lvd2/zxnetusb/reports/2019_dihalt_summer/epm3128_pre.jpg

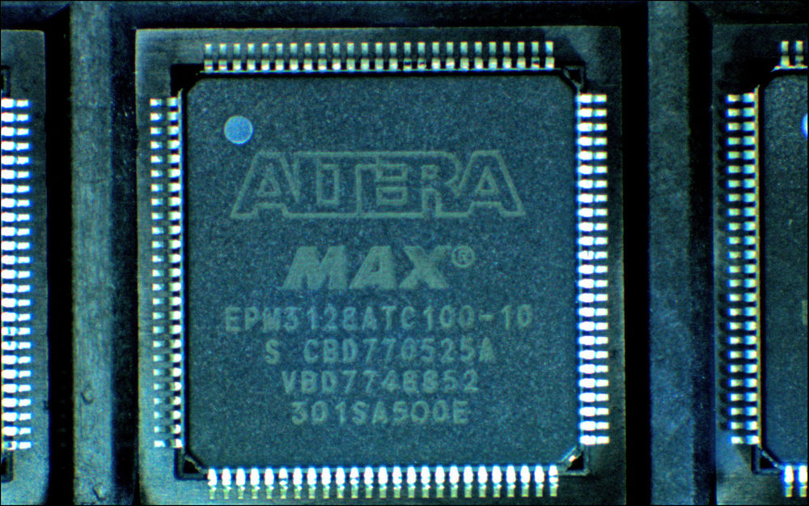
reports/2019_dihalt_summer/epm3128_pre.jpg
