lvd2/zxnetusb/reports/2019_dihalt_summer/W5300.jpg

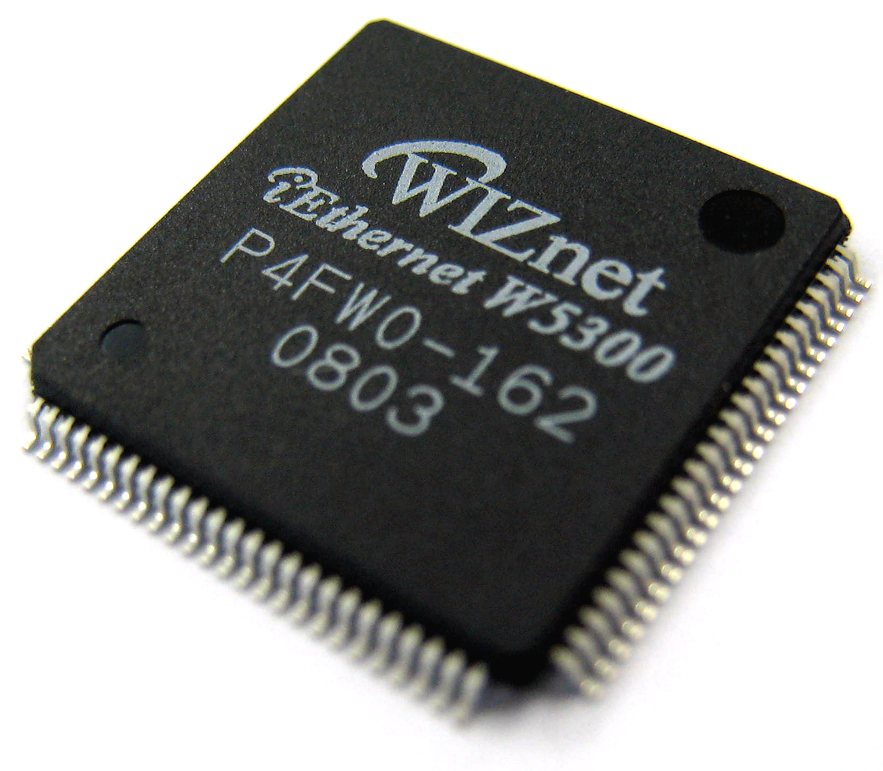
reports/2019_dihalt_summer/W5300.jpg
