lvd2/zxnetusb/pcad/readme.txt

Revision A: initial

Revision B:
- Исправлено RJ45 element.
- ПОдвинут USB разъем ровно по краю платы.
