lvd2/zxnetusb/pcad/revC4/photos/DSCN5782.png

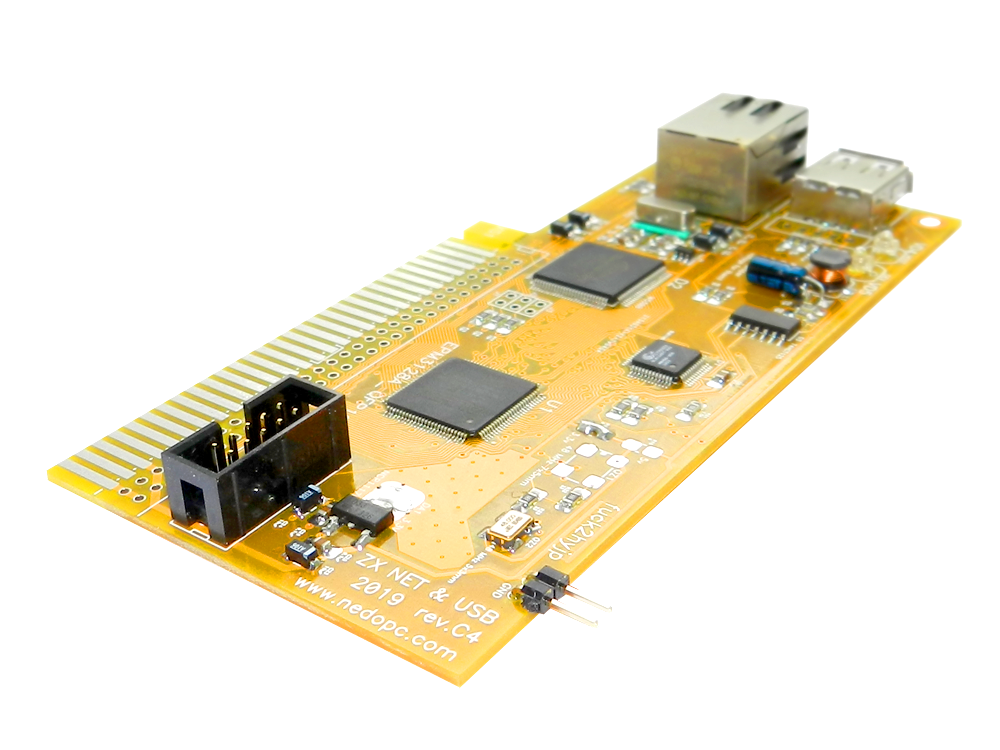
pcad/revC4/photos/DSCN5782.png
