lvd2/zxnetusb/pcad/revC4/photos/revC4_bot.jpg

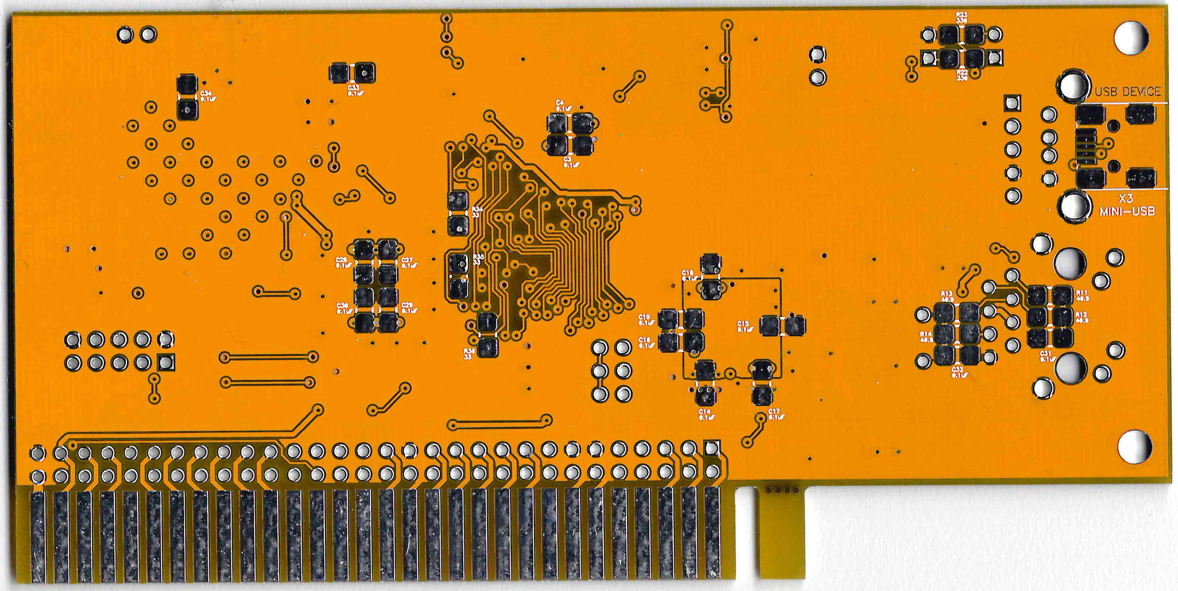
pcad/revC4/photos/revC4_bot.jpg
