lvd2/zxnetusb/pcad/revC4/photos/revC4_top.jpg

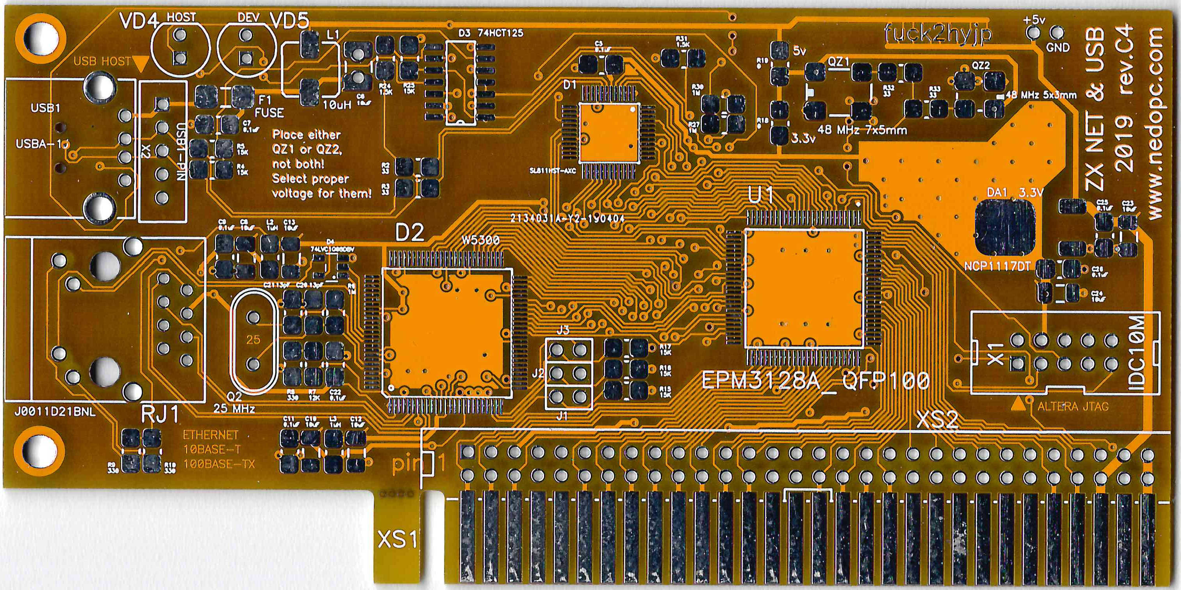
pcad/revC4/photos/revC4_top.jpg
