lvd2/zxnetusb/reports/2019_cafe/abstract/333.png

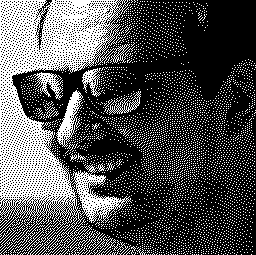
reports/2019_cafe/abstract/333.png
