lvd2/zxnetusb/reports/2019_cafe/w5100_1.jpg

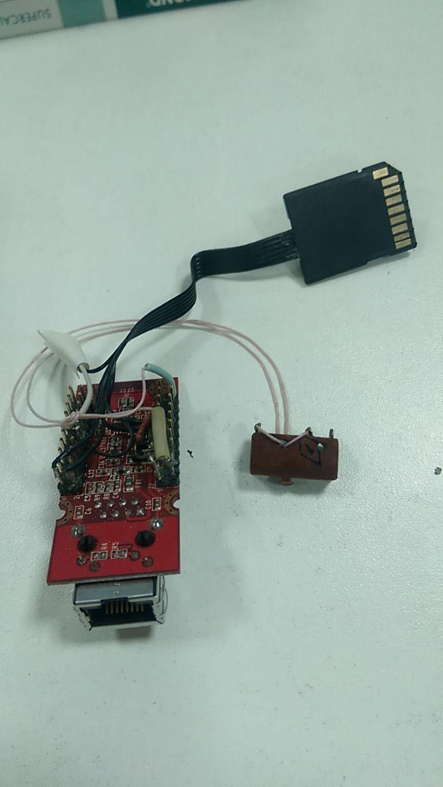
reports/2019_cafe/w5100_1.jpg
