lvd2/zxnetusb/reports/2019_cafe/w5100_2.jpg

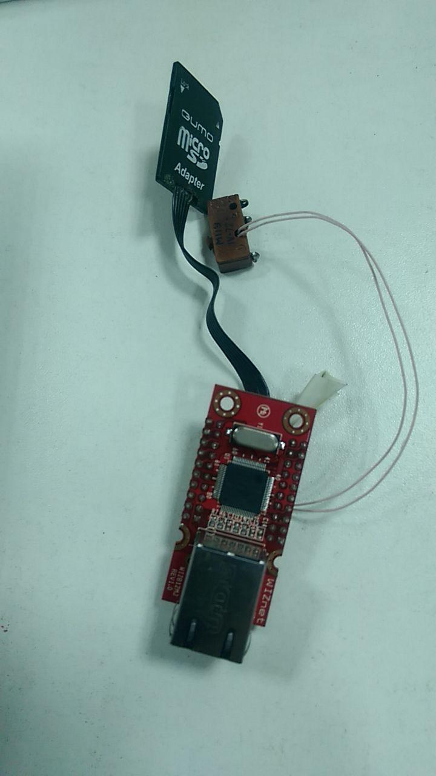
reports/2019_cafe/w5100_2.jpg
