lvd2/zxnetusb/pcad/revC4/zxinet_bom.ods

Количество/Count | Обозначение/RefDes | Тип/Type | Корпус/Package | Номинал/Value | Комменатрии/Comments
1 | U1 | Altera EPM3128ATC100-10N | QFP 100
1 | D1 | Cypress SL811HS | QFP 48
1 | D2 | Wiznet W5300 | QFP 100
1 | D3 | 74HCT125 | SOIC 14
1 | D4 | 74LVC1G08DBV | SOT23-5 |  | также/also 74HC1G08
1 | DA1 | NCP1117DT | DPAK, SOT223 | 3.3V | также/also LM1117-3.3
23 | C3 | Ceramic capacitor | 0805, 1206 | 0.1uF X7R
 | C4 | Ceramic capacitor | 0805, 1206 | 0.1uF X7R
 | C5 | Ceramic capacitor | 0805, 1206 | 0.1uF X7R
 | C7 | Ceramic capacitor | 0805, 1206 | 0.1uF X7R
 | C9 | Ceramic capacitor | 0805, 1206 | 0.1uF X7R
 | C11 | Ceramic capacitor | 0805, 1206 | 0.1uF X7R
 | C14 | Ceramic capacitor | 0805, 1206 | 0.1uF X7R
 | C15 | Ceramic capacitor | 0805, 1206 | 0.1uF X7R
 | C16 | Ceramic capacitor | 0805, 1206 | 0.1uF X7R
 | C17 | Ceramic capacitor | 0805, 1206 | 0.1uF X7R
 | C18 | Ceramic capacitor | 0805, 1206 | 0.1uF X7R
 | C19 | Ceramic capacitor | 0805, 1206 | 0.1uF X7R
 | C22 | Ceramic capacitor | 0805, 1206 | 0.1uF X7R
 | C25 | Ceramic capacitor | 0805, 1206 | 0.1uF X7R
 | C26 | Ceramic capacitor | 0805, 1206 | 0.1uF X7R
 | C27 | Ceramic capacitor | 0805, 1206 | 0.1uF X7R
 | C28 | Ceramic capacitor | 0805, 1206 | 0.1uF X7R
 | C29 | Ceramic capacitor | 0805, 1206 | 0.1uF X7R
 | C30 | Ceramic capacitor | 0805, 1206 | 0.1uF X7R
 | C31 | Ceramic capacitor | 0805, 1206 | 0.1uF X7R
 | C32 | Ceramic capacitor | 0805, 1206 | 0.1uF X7R
 | C33 | Ceramic capacitor | 0805, 1206 | 0.1uF X7R | Устанавливать только один из двух/Install only one of two
 | C34 | Ceramic capacitor | 0805, 1206 | 0.1uF X7R | Устанавливать только один из двух/Install only one of two
2 | C20 | Ceramic capacitor | 0805, 1206 | 13pF NPO
 | C21 | Ceramic capacitor | 0805, 1206 | 13pF NPO
6 | C8 | Tantalum capacitor | 1206 (A) | 10uF 16v
 | C10 | Tantalum capacitor | 1206 (A) | 10uF 16v
 | C12 | Tantalum capacitor | 1206 (A) | 10uF 16v
 | C13 | Tantalum capacitor | 1206 (A) | 10uF 16v
 | C23 | Tantalum capacitor | 1206 (A) | 10uF 16v
 | C24 | Tantalum capacitor | 1206 (A) | 10uF 16v
1 | C6 | Tantalum capacitor | 1206 (A) | 10uF 16v
1 | L1 | Inductor | CDR64B | 10uH | CDRH64B, 1812 (4.5mm*2.5mm), любой/any other на ток/current >0.5A размер не более/size not greater than 6x6mm
2 | L2 | Chip inductor | 0805, 1206 | 1uH
 | L3 | Chip inductor | 0805, 1206 | 1uH
1 | F1 | FUSE | SMD1210
2 | R18 | Resistor | 0805, 1206 | 0 Ohm or solder bridge | Устанавливать только один из двух/Install only one of two
 | R19 | Resistor | 0805, 1206 | 0 Ohm or solder bridge | Устанавливать только один из двух/Install only one of two
3 | R6 | Resistor | 0805, 1206 | 1M
 | R27 | Resistor | 0805, 1206 | 1M
 | R30 | Resistor | 0805, 1206 | 1M
2 | R24 | Resistor | 0805, 1206 | 1.5K
 | R31 | Resistor | 0805, 1206 | 1.5K
1 | R7 | Resistor | 0805, 1206 | 12K
6 | R4 | Resistor | 0805, 1206 | 15K
 | R5 | Resistor | 0805, 1206 | 15K
 | R15 | Resistor | 0805, 1206 | 15K
 | R16 | Resistor | 0805, 1206 | 15K
 | R17 | Resistor | 0805, 1206 | 15K
 | R25 | Resistor | 0805, 1206 | 15K
7 | R2 | Resistor | 0805, 1206 | 33
 | R3 | Resistor | 0805, 1206 | 33
 | R32 | Resistor | 0805, 1206 | 33 | Устанавливать только один из двух/Install only one of two
 | R33 | Resistor | 0805, 1206 | 33 | Устанавливать только один из двух/Install only one of two
 | R34 | Resistor | 0805, 1206 | 33
 | R35 | Resistor | 0805, 1206 | 33
 | R36 | Resistor | 0805, 1206 | 33
4 | R11 | Resistor | 0805, 1206 | 49.9
 | R12 | Resistor | 0805, 1206 | 49.9
 | R13 | Resistor | 0805, 1206 | 49.9
 | R14 | Resistor | 0805, 1206 | 49.9
5 | R8 | Resistor | 0805, 1206 | 330
 | R9 | Resistor | 0805, 1206 | 330
 | R10 | Resistor | 0805, 1206 | 330
 | R22 | Resistor | 0805, 1206 | 330
 | R23 | Resistor | 0805, 1206 | 330
1 | Q2 | Quartz crystal | HC-49 | 25.0 MHz
1 | QZ2 | Quartz generator | 5mm x 3.2mm | 48.0 MHz | Устанавливать только один из двух/Install only one of two
1 | QZ1 | Quartz generator | 7mm x 5mm | 48.0 MHz | Устанавливать только один из двух/Install only one of two
1 | VD5 | LED | 100mil
1 | VD4 | LED | 100mil
1 | X1 | male connector | IDC10M |  | Altera JTAG
1 | RJ1 | J0011D21B |  |  | также/also J0011D21BNL
1 | J1 | jumper | 2pin 100mil
1 | J2 | jumper | 2pin 100mil
1 | J3 | jumper | 2pin 100mil
1 | X2 | pins | PLS-5
1 | X3 | MINI-USB type B receptacle |  |  | поверхностный монтаж/surface-mount
1 | USB1 | USB type A receptacle |  |  | монтаж в отверстия/through-hole
