lvd2/zxnetusb/doc/revC/zxinet_sch.pdf

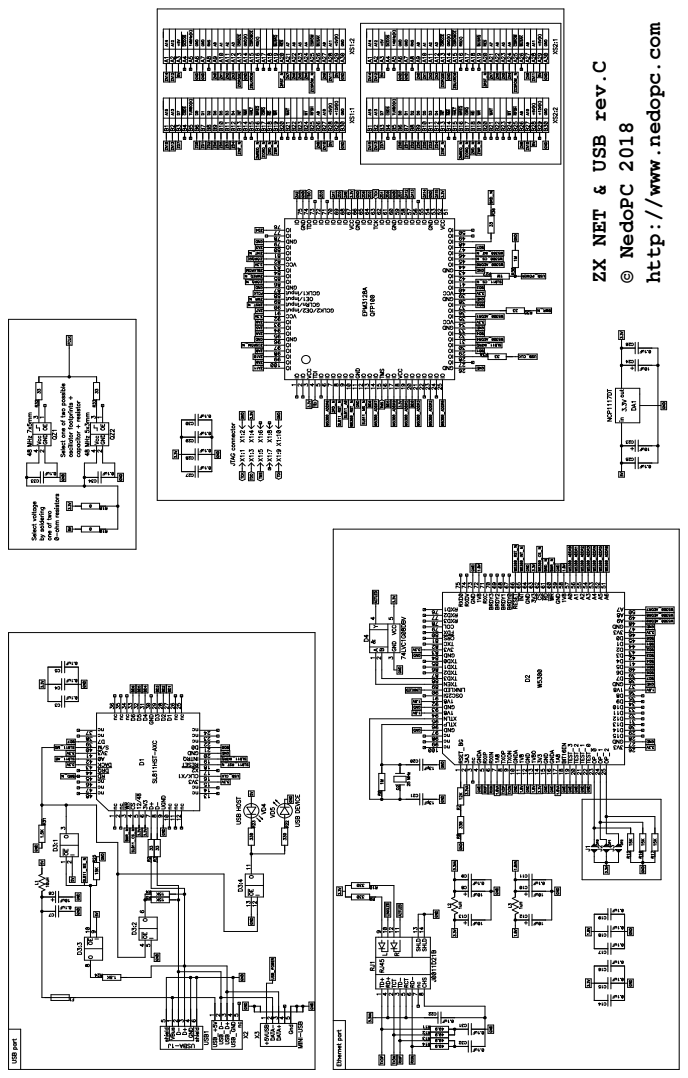
[picture p26: page 1]
© NedoPC 2018

http://www.nedopc.com

ZX NET & USB rev.C
