lvd2/zxnetusb/doc/revA/patch_rev_a.pdf

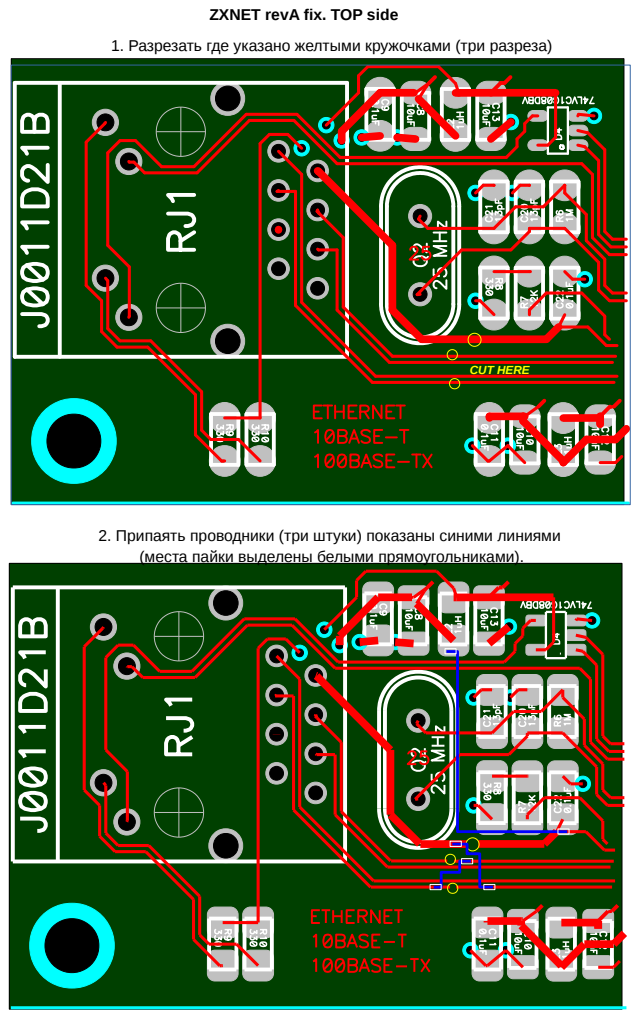
[picture p27: page 1]
CUT HERE

ZXNET revA fix. TOP side

1. Разрезать где указано желтыми кружочками (три разреза)

2. Припаять проводники (три штуки) показаны синими линиями
(места пайки выделены белыми прямоугольниками).

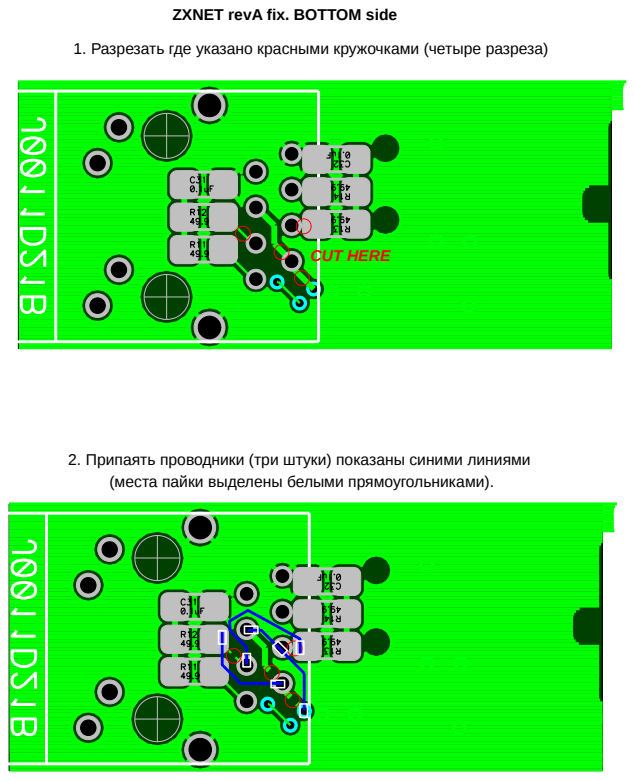
[picture p28: page 2]
CUT HERE

ZXNET revA fix. BOTTOM side

1. Разрезать где указано красными кружочками (четыре разреза)

2. Припаять проводники (три штуки) показаны синими линиями
(места пайки выделены белыми прямоугольниками).
