lvd2/zxnetusb/(list of files, drawings)

Other design files:
pcad/old/NeoGS.pcb
pcad/revA/zxinet.pcb
pcad/revB/zxinet.pcb
pcad/revC3/zxinet_C3.pcb
pcad/revC4/zxinet.pcb
