lvd2/zxnetusb/(commit log)

2012-10-03 added some old libs and PCBs from other projects
    [NeoGS.pcb]
2012-10-04 added lib from zxcyclone, added ether connector pdf
2012-10-15 add driver w5300
2012-10-24 add USBA-2J connector
2012-10-27 add scheme (SL811 and clockgen)
    [zxinet.sch]
2012-10-27 sch: ethernet & USB frontend part lib: add components
    [zxinet.sch]
2012-10-28 sch: add some elements (close circuit of ethernet transformer)
    [zxinet.sch]
2012-10-31 updated schematics a bit
    [zxinet.sch]
2012-10-31 changed specs: added BRDY read, added USB power control bits
2012-10-31 sch: USB frontend on LM3525M-L lib: add LM3525M-L component
    [zxinet.sch]
2012-11-03 added USB master/slave switching circuits, changed HDL to buffer databus, removed BRDY read from specs
    [zxinet.sch]
2012-11-04 finished USB-part, ZXBUS-part
    [zxinet.sch]
2012-11-06 added usb host and device LEDs, removed some transistors for 74hct125
    [zxinet.sch]
2012-11-11 finished testbench for current cpld code
2012-11-13 lib: add USB pin connector sch: - add USB pin connector - correct USB led part - fill title
    [zxinet.sch]
2012-11-15 lib: add ZXBUS-PIN sch: add ZXBUS-PIN pcb: start version
    [zxinet.pcb, zxinet.sch]
2012-11-15 added transistor repeater for ACTLED light diode
    [zxinet.sch]
2012-11-16 lib: add 74LVC1G08DBV sch: ACTLED on 74LVC1G08DBV
    [zxinet.sch]
2012-11-17 changed pins on CPLD for zxbus
    [zxinet.sch]
2012-11-18 PCB: zxbus and w5300 frontend
    [zxinet.pcb]
2012-11-23 lib: add CD64R ferrit sch: USB ferrit exchange to CD64R pcb: routed board
    [zxinet.pcb, zxinet.sch]
2012-11-24 PCB: diff pairs reroute
    [zxinet.pcb]
2012-11-24 PCB: - C31R11R12 and C32R13R14 to bottom side; - add some text on board.
    [zxinet.pcb]
2012-12-02 LIB: Add MIC2025-YM SCH: Alternative usb power switch on MIC2025-YM PCB: Add alternative power switch on bottom side
    [zxinet.pcb, zxinet.sch]
2013-03-29 replacement driver for 8 bit version
    [main.c]
2013-04-03 zxiznet: fixed reset behavior of ms bit: now it's reset only on zx reset, not on sl811 reset. doc fixed, new .pof built
    [ports.v]
2013-04-04 Update documents
    [detaly.ods]
2013-04-15 Revision B started
    [zxinet.pcb, zxinet.sch]
2013-09-22 zxiznet: partially removed glitch problem by adding filters to cpld design, more glitches to kill
    [top.v, zbus.v]
2013-10-03 zxiznet: trying to fix glitches...
    [ports.v, ssz80.v, tb.v, top.v, wizmap.v]
2013-10-03 zxiznet: trunk now is without bugfixes, all bugfixes is in branch/ dir
    [top.v, zbus.v]
2013-10-21 add w5300 sample
2017-09-19 trunk: fixed obvious bug in tests
    [tb.v]
2017-09-19 trunk: added clocked filter, patched testbench to pass tests with that filter
2018-01-08 zxiznet: included revC sch and pcb into trunk
    [zxinet.pcb, zxinet.sch, zxinet_tmp.sch]
2018-01-08 zxiznet: making gerbers for revC
    [ZXINET.DRL, ZXINET.GBL, ZXINET.GBO, ZXINET.GBS, ZXINET.GKO, ZXINET.GTL, ZXINET.GTO, ZXINET.GTS]
2018-01-08 zxiznet: finished revC pcb and gerbers
    [zxinet.pcb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]
2018-01-29 zxiznet: added .bom, tidied up files (removed unnecessary ones)
    [zxinet_tmp.sch]
2018-02-04 zxiznet: spawned simpe pin-test for epm3128 (DO NOT INSERT INTO ZXBUS\!\!\!)
2018-02-04 zxiznet: revC: made pin test (see readme and top.v), compiled top.pof of main project, added empty epm config (read from empty device)
2018-02-04 zxiznet: pcad lib: miniUSB corrected (wider gnd pins)
2018-02-05 zxiznet: gerbers archive added
2018-02-05 zxiznet: fixed years in rtl, spawned revC documentation
    [ports.v, top.v, wizmap.v, zbus.v]
2018-02-06 zxiznet: revC schematics: cosmetic changes
    [zxinet.sch]
2018-02-09 zxiznet: fixing for 14mhz: w5300 works OK, sl811 always fails (any freq)
    [zbus.v]
2018-02-11 zxiznet: fixing for 14mhz: sl811 seems to work also, but fix overall is BAAAD. Will do lOOOng tests though
    [tb.v, zbus.v]
2018-02-19 added datasheets to esp32
2018-02-25 zxiznet: added esp32 devkitc schematics
2018-03-04 zxiznet: fix for bad memmapped w5300 reads when extra bytes appeared or some disappearing. still read glitches at 14mhz, when some zero bits of read byte turn to 1 (also memmaped w5300)
    [zbus.v]
2018-03-05 zxiznet: proposed fix for data setup violation in memmaped wiznet memtest
    [zbus.v]
2018-03-05 zxiznet: updated fix for <look prev commit>
    [zbus.v]
2018-03-28 zxiznet: added .svg with schematics
2018-03-29 zxiznet: svg schematics updated
2018-03-29 zxiznet: rev.C: finished PDF schematics, BOM in progress
    [zxinet_bom.ods]
2018-03-29 zxiznet: rev.C: BOM
    [zxinet_bom.ods]
2019-04-03 zxiznet: rev.D added (changes in README)
    [zxinet.pcb, zxinet.sch, zxinet_bom.ods]
2019-04-03 zxiznet: rev.D: added gerbers
    [ZXINET.DRL, ZXINET.GBL, ZXINET.GBO, ZXINET.GBS, ZXINET.GKO, ZXINET.GTL, ZXINET.GTO, ZXINET.GTS]
2019-04-04 zxiznet: revD renamed to revC4
    [ZXINET.DRL, ZXINET.GBL, ZXINET.GBO, ZXINET.GBS, ZXINET.GKO, ZXINET.GTL, ZXINET.GTO, ZXINET.GTS]
2019-04-04 zxinet: added mount pdfs and BOM to revC
    [zxinet_bom.ods]
2019-04-04 zxiznet: added docs for rev.C
    [zxinet_bom.ods]
2019-04-04 zxiznet: rev.C: fixed typos in BOM
    [zxinet_bom.ods]
2019-04-07 zxiznet: doc for rev.C (current cpld fw) fixed, 10x to DimkaM
2019-05-10 Поправил документацию
    [detaly.ods, zxinet_bom.ods]
2019-05-12 Привел в человеческий вид документацию
    [zxinet_bom.ods]
2019-05-13 zxiznet: revC4: added more pcb photos
2019-10-21 zxiznet; new report materials
2020-05-06 Добавлена версия производимая Tetroid'ом: ревижен C3
    [zxinet_C3.pcb]
